LehyanFlouriot/Projet-Drone/PCB/schemaScreen.PNG

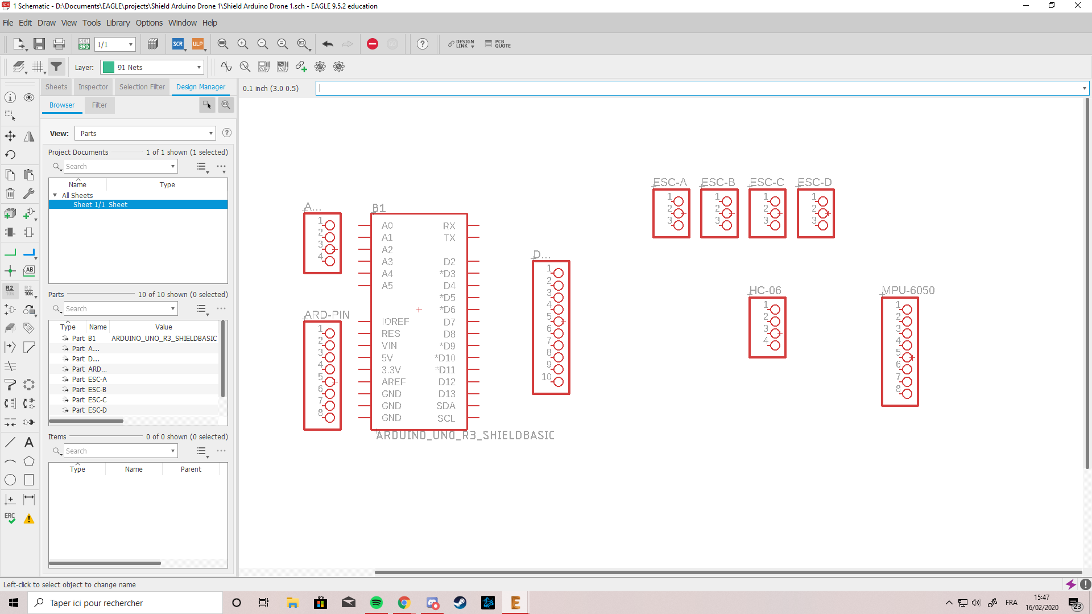
PCB/schemaScreen.PNG
