LehyanFlouriot/Projet-Drone/Impresion 3D/PIÈCE2.STL

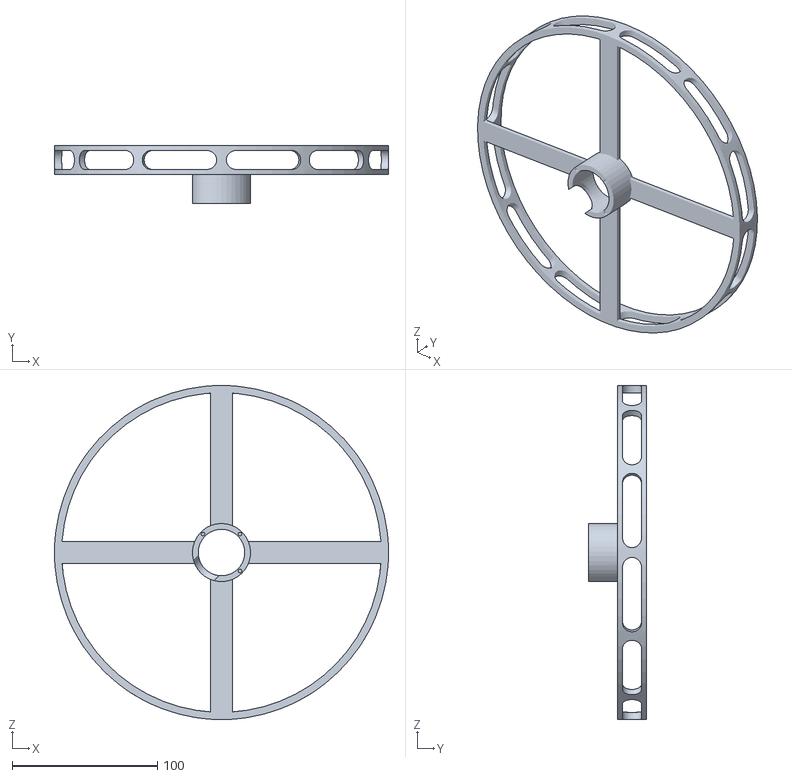
[picture p70: CAD file, 2020-02-17]
Impresion 3D/PIÈCE2.STL
229.9 x 40.0 x 230.0
