LehyanFlouriot/Projet-Drone/Impresion 3D/Pièce1.STL

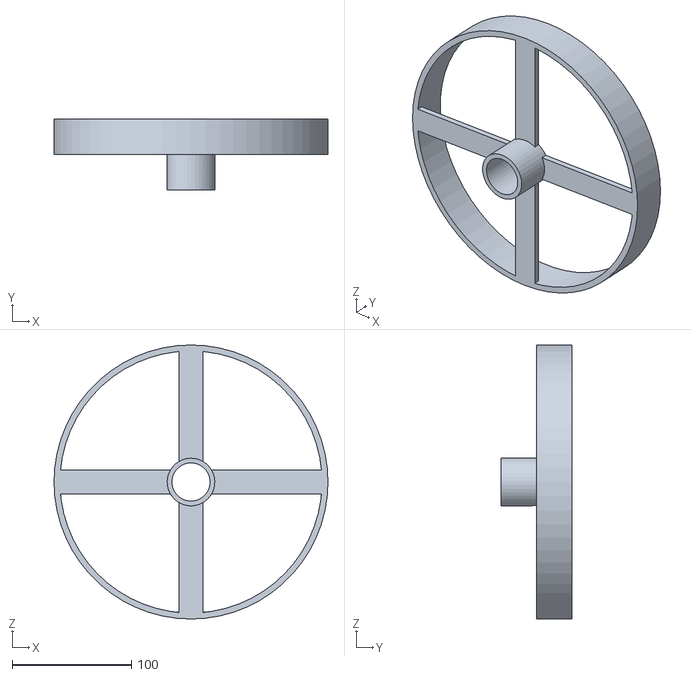
[picture p71: CAD file, 2020-02-17]
Impresion 3D/Pièce1.STL
230.0 x 60.0 x 230.0
