LehyanFlouriot/Projet-Drone/PCB/Shield Arduino Drone 1/Shield Arduino Drone 1.brd

## EAGLE design PCB/Shield Arduino Drone 1/Shield Arduino Drone 1.brd (2020-02-16)

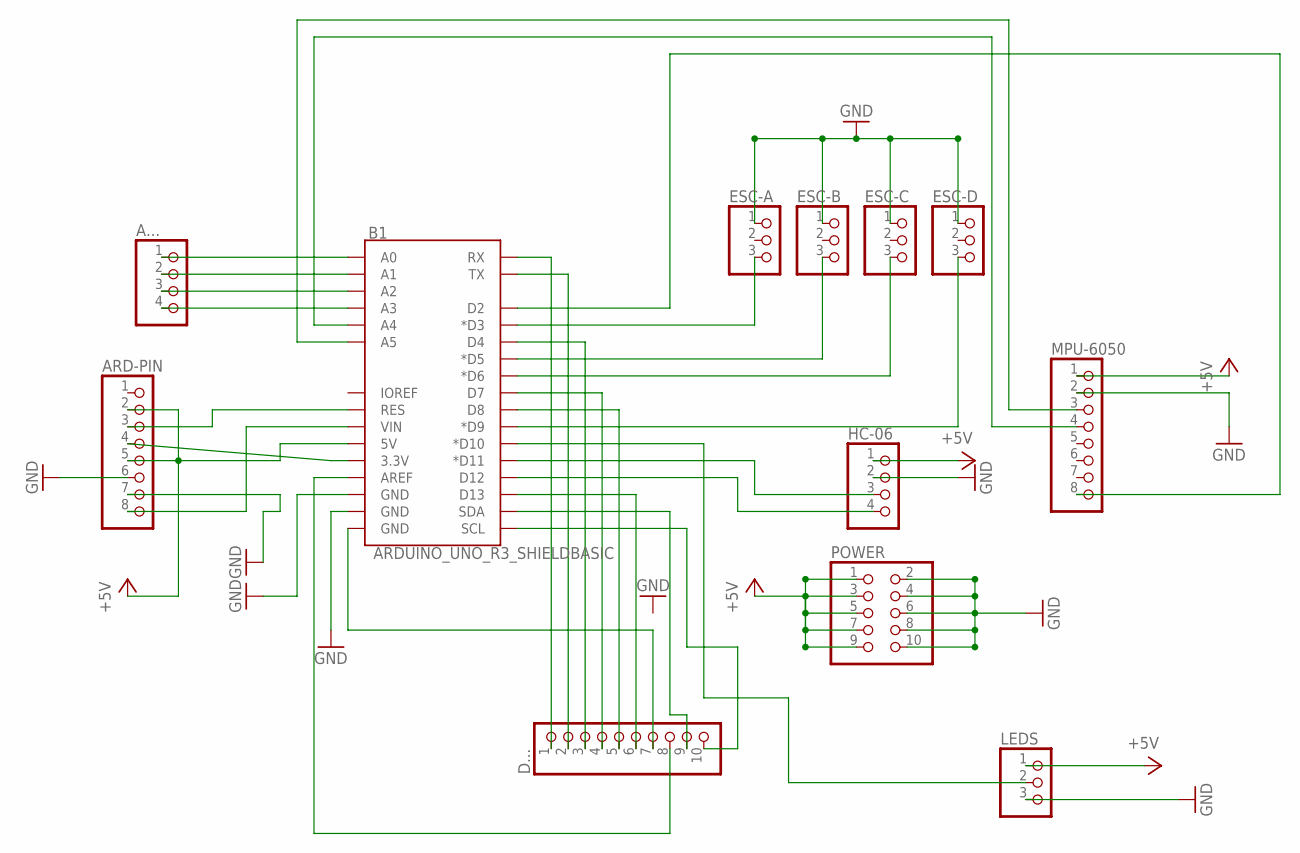
[picture p72: schematic Shield Arduino Drone 1.sch]

Parts:
A...: PINHD-1X4; 1X04
ARD-PIN: PINHD-1X8; 1X08
B1: ARDUINO_UNO_R3_SHIELDBASIC; UNO_R3_SHIELD
D...: PINHD-1X10; 1X10
ESC-A: PINHD-1X3; 1X03
ESC-B: PINHD-1X3; 1X03
ESC-C: PINHD-1X3; 1X03
ESC-D: PINHD-1X3; 1X03
HC-06: PINHD-1X4; 1X04
LEDS: PINHD-1X3; 1X03
MPU-6050: PINHD-1X8; 1X08
POWER: PINHD-2X5; 2X05

Connections:
+5V: ARD-PIN.2, ARD-PIN.5, B1.5V, HC-06.1, LEDS.1, MPU-6050.1, POWER.1, POWER.3, POWER.5, POWER.7, POWER.9
GND: ARD-PIN.6, ARD-PIN.7, B1.GND@1 (GND), B1.GND@2 (GND), ESC-A.1, ESC-B.1, ESC-C.1, ESC-D.1, HC-06.2, LEDS.3, MPU-6050.2, POWER.2, POWER.4, POWER.6, POWER.8, POWER.10
unnamed: B1.A5, MPU-6050.3
unnamed: B1.A4, MPU-6050.4
unnamed: B1.D2, MPU-6050.8
unnamed: B1.D11 (*D11), HC-06.3
unnamed: B1.D12, HC-06.4
unnamed: A....1, B1.A0
unnamed: A....2, B1.A1
unnamed: A....3, B1.A2
unnamed: A....4, B1.A3
unnamed: ARD-PIN.8, B1.VIN
unnamed: ARD-PIN.3, B1.RES
unnamed: B1.D13, D....6
unnamed: B1.RX, D....1
unnamed: ARD-PIN.4, B1.3.3V
unnamed: B1.TX, D....2
unnamed: B1.D3 (*D3), ESC-A.3
unnamed: B1.D4, D....3
unnamed: B1.D5 (*D5), ESC-B.3
unnamed: B1.D6 (*D6), ESC-C.3
unnamed: B1.D7, D....4
unnamed: B1.D8, D....5
unnamed: B1.D9 (*D9), ESC-D.3
unnamed: B1.D10 (*D10), LEDS.2
unnamed: B1.AREF, D....8
unnamed: B1.SDA, D....9
unnamed: B1.SCL, D....10
unnamed: B1.GND@0 (GND), D....7

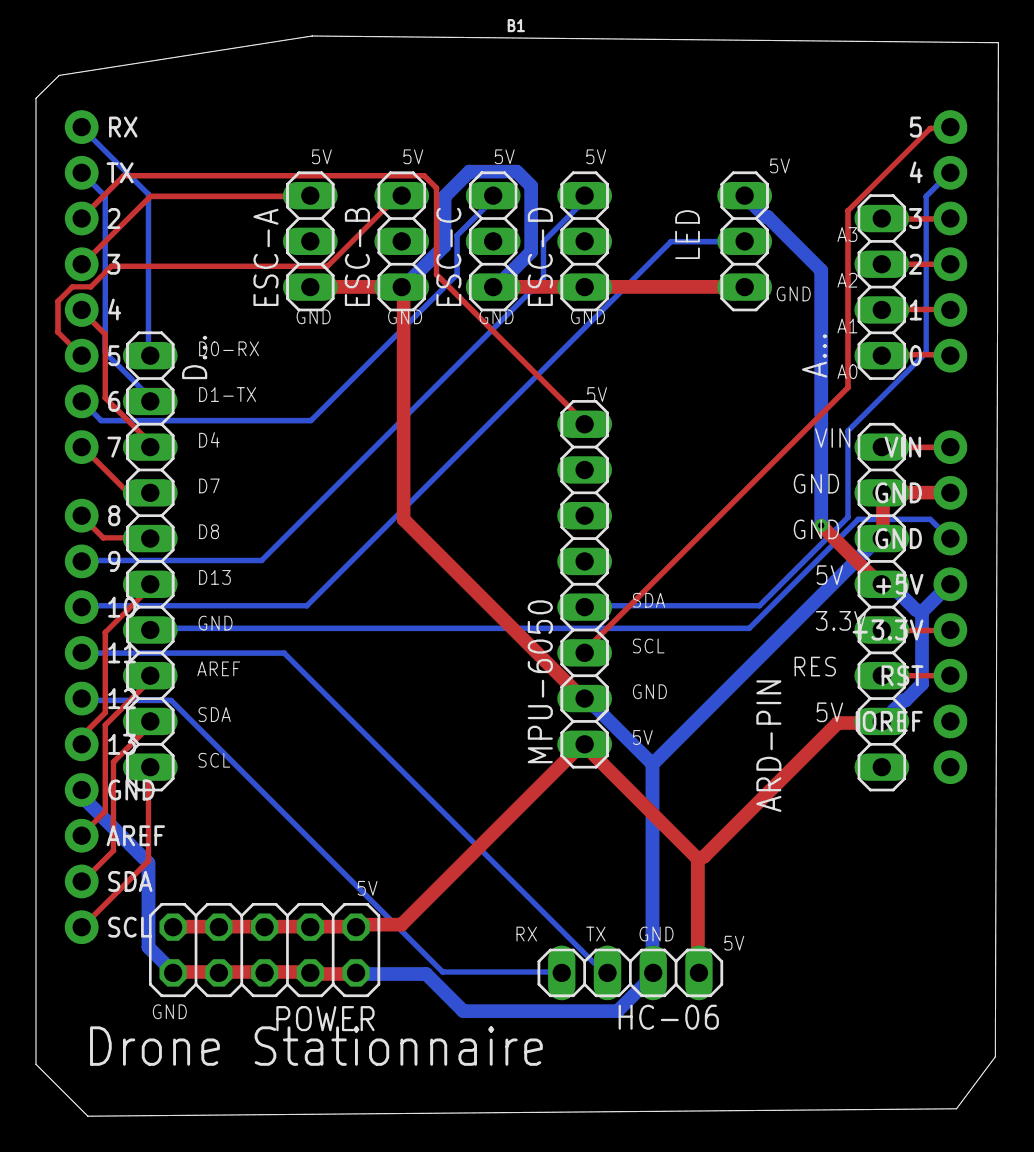
[picture p73: board Shield Arduino Drone 1.brd from above]

Board: 2 copper layers, 53.5 x 60.0 mm, 12 parts (0 on the bottom side), 29 nets.
